nickbild/555_doom_pcb/555_doom_kicad/555_doom_kicad.kicad_pcb

## KiCad design 555_doom_kicad/555_doom_kicad.kicad_pcb (2026-09-07)

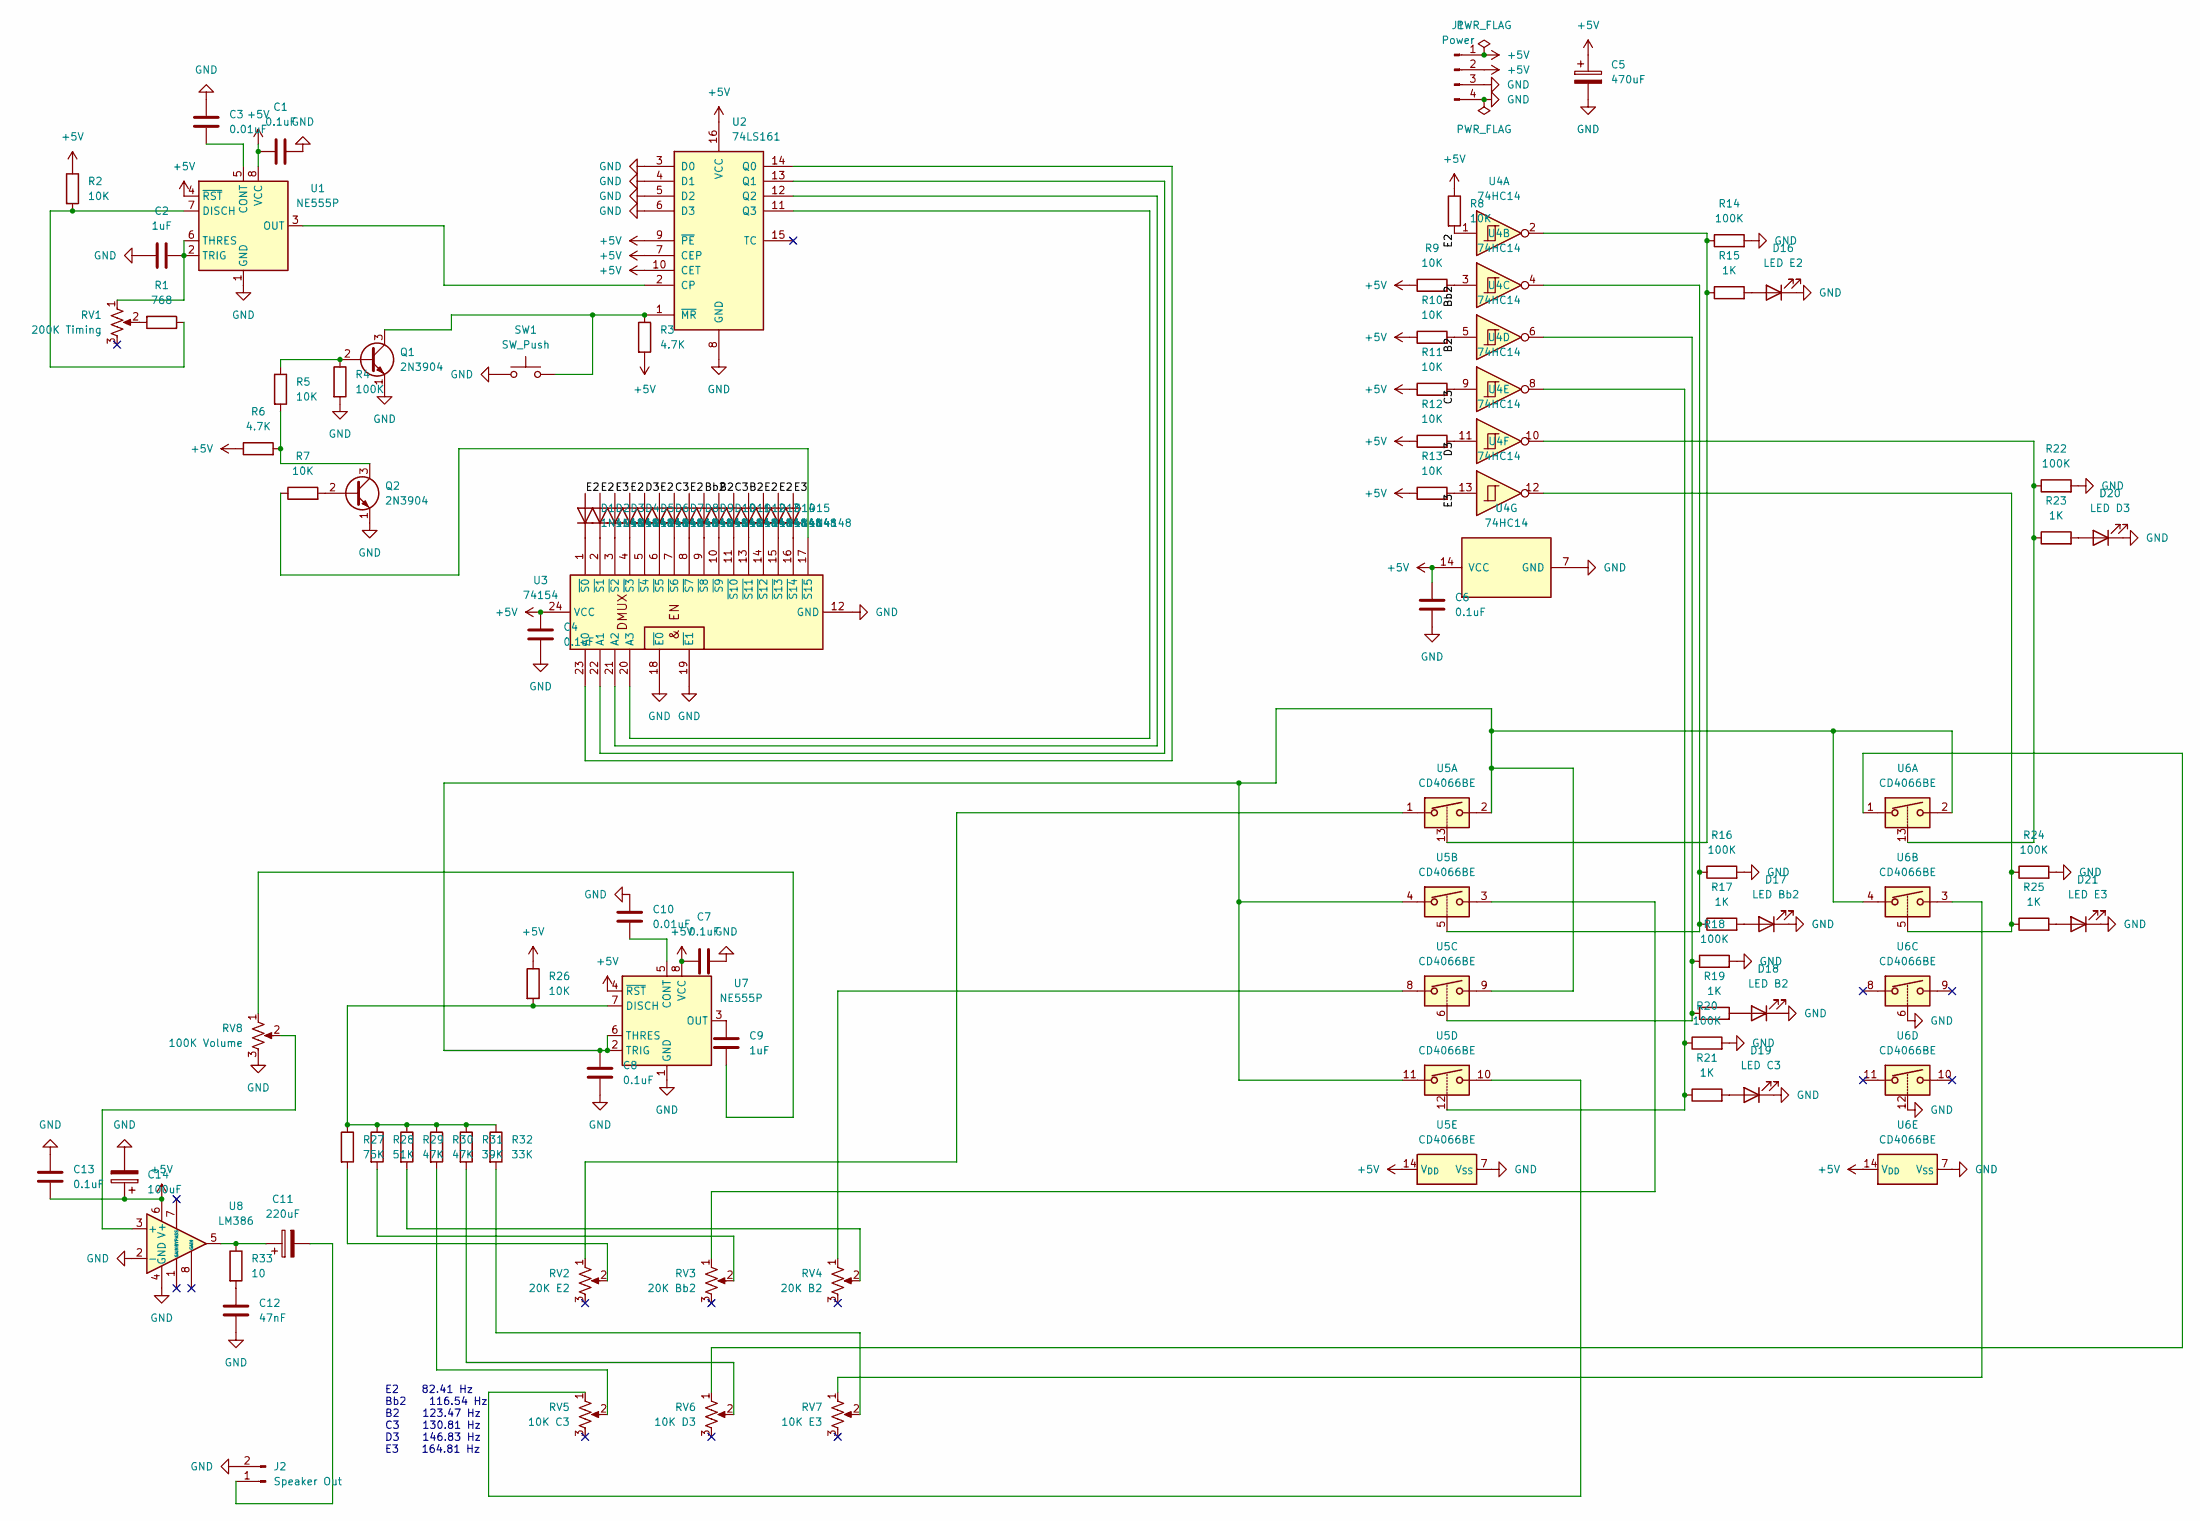
[picture p1: schematic 555_doom_kicad.kicad_sch]

Parts:
C1, C4, C6, C7, C8, C13: 0.1uF; C_Disc_D4.7mm_W2.5mm_P5.00mm
C2, C9: 1uF; C_Disc_D4.7mm_W2.5mm_P5.00mm
C3, C10: 0.01uF; C_Disc_D4.7mm_W2.5mm_P5.00mm
C5: 470uF; CP_Radial_D8.0mm_P2.50mm
C11: 220uF; CP_Radial_D5.0mm_P2.50mm
C12: 47nF; C_Disc_D4.7mm_W2.5mm_P5.00mm
C14: 100uF; CP_Radial_D5.0mm_P2.50mm
D1, D2, D3, D4, D5, D6, D7, D8, D9, D10, D11, D12, D13, D14, D15: 1N4148; D_T-1_P5.08mm_Horizontal
D16: LED E2; LED_D5.0mm
D17: LED Bb2; LED_D5.0mm
D18: LED B2; LED_D5.0mm
D19: LED C3; LED_D5.0mm
D20: LED D3; LED_D5.0mm
D21: LED E3; LED_D5.0mm
J1: Power; PinHeader_1x04_P2.54mm_Vertical
J2: Speaker Out; PinHeader_1x02_P2.54mm_Vertical
Q1, Q2: 2N3904; TO-92_Inline_Wide
R1: 768; R_Axial_DIN0207_L6.3mm_D2.5mm_P7.62mm_Horizontal
R2, R5, R7, R8, R9, R10, R11, R12, R13, R26: 10K; R_Axial_DIN0207_L6.3mm_D2.5mm_P7.62mm_Horizontal
R3, R6: 4.7K; R_Axial_DIN0207_L6.3mm_D2.5mm_P7.62mm_Horizontal
R4, R14, R16, R18, R20, R22, R24: 100K; R_Axial_DIN0207_L6.3mm_D2.5mm_P7.62mm_Horizontal
R15, R17, R19, R21, R23, R25: 1K; R_Axial_DIN0207_L6.3mm_D2.5mm_P7.62mm_Horizontal
R27: 75K; R_Axial_DIN0207_L6.3mm_D2.5mm_P7.62mm_Horizontal
R28: 51K; R_Axial_DIN0207_L6.3mm_D2.5mm_P7.62mm_Horizontal
R29, R30: 47K; R_Axial_DIN0207_L6.3mm_D2.5mm_P7.62mm_Horizontal
R31: 39K; R_Axial_DIN0207_L6.3mm_D2.5mm_P7.62mm_Horizontal
R32: 33K; R_Axial_DIN0207_L6.3mm_D2.5mm_P7.62mm_Horizontal
R33: 10; R_Axial_DIN0207_L6.3mm_D2.5mm_P7.62mm_Horizontal
RV1: 200K Timing; Potentiometer_ACP_CA9-H5_Horizontal
RV2: 20K E2; Potentiometer_ACP_CA9-H5_Horizontal
RV3: 20K Bb2; Potentiometer_ACP_CA9-H5_Horizontal
RV4: 20K B2; Potentiometer_ACP_CA9-H5_Horizontal
RV5: 10K C3; Potentiometer_ACP_CA9-H5_Horizontal
RV6: 10K D3; Potentiometer_ACP_CA9-H5_Horizontal
RV7: 10K E3; Potentiometer_ACP_CA9-H5_Horizontal
RV8: 100K Volume; Potentiometer_ACP_CA9-H5_Horizontal
SW1: SW_Push; SW_PUSH_6mm_H7.3mm
U1, U7: NE555P; DIP-8_W7.62mm
U2: 74LS161; DIP-16_W7.62mm
U3: 74154; DIP-24_W15.24mm
U4: 74HC14; DIP-14_W7.62mm
U5, U6: CD4066BE; DIP-14_W7.62mm
U8: LM386; DIP-8_W7.62mm

Connections:
+5V: C1.1, C4.1, C5.1, C6.1, C7.1, C13.2, C14.1, J1.1, J1.2, R2.1, R3.2, R6.1, R8.1, R9.1, R10.1, R11.1, R12.1, R13.1, R26.1, U1.4 (~RST), U1.8 (VCC), U2.7 (CEP), U2.9 (~PE), U2.10 (CET), U2.16 (VCC), U3.24 (VCC), U4.14 (VCC), U5.14 (V_{DD}), U6.14 (V_{DD}), U7.4 (~RST), U7.8 (VCC), U8.6 (V+)
/B2: D10.2 (A), D12.2 (A), R10.2, U4.5
/Bb2: D9.2 (A), R9.2, U4.3
/C3: D7.2 (A), D11.2 (A), R11.2, U4.9
/D3: D5.2 (A), R12.2, U4.11
/E2: D1.2 (A), D2.2 (A), D4.2 (A), D6.2 (A), D8.2 (A), D13.2 (A), D14.2 (A), R8.2, U4.1
/E3: D3.2 (A), D15.2 (A), R13.2, U4.13
GND: C1.2, C2.2, C3.1, C4.2, C5.2, C6.2, C7.2, C8.2, C10.1, C12.2, C13.1, C14.2, D16.1 (K), D17.1 (K), D18.1 (K), D19.1 (K), D20.1 (K), D21.1 (K), J1.3, J1.4, J2.2, Q1.1 (E), Q2.1 (E), R4.2, R14.2, R16.2, R18.2, R20.2, R22.2, R24.2, RV8.3, SW1.1, U1.1 (GND), U2.3 (D0), U2.4 (D1), U2.5 (D2), U2.6 (D3), U2.8 (GND), U3.12 (GND), U3.18 (~E0), U3.19 (~E1), U4.7 (GND), U5.7 (V_{SS}), U6.6, U6.7 (V_{SS}), U6.12, U7.1 (GND), U8.2 (-), U8.4 (GND)
unnamed: C9.2, RV8.1
unnamed: C11.1, R33.1, U8.5
unnamed: C12.1, R33.2
unnamed: D1.1 (K), U3.1 (~S0)
unnamed: D2.1 (K), U3.2 (~S1)
unnamed: D3.1 (K), U3.3 (~S2)
unnamed: D4.1 (K), U3.4 (~S3)
unnamed: D5.1 (K), U3.5 (~S4)
unnamed: D6.1 (K), U3.6 (~S5)
unnamed: D7.1 (K), U3.7 (~S6)
unnamed: D8.1 (K), U3.8 (~S7)
unnamed: D9.1 (K), U3.9 (~S8)
unnamed: D10.1 (K), U3.10 (~S9)
unnamed: D11.1 (K), U3.11 (~S10)
unnamed: D12.1 (K), U3.13 (~S11)
unnamed: D13.1 (K), U3.14 (~S12)
unnamed: D14.1 (K), U3.15 (~S13)
unnamed: D15.1 (K), U3.16 (~S14)
unnamed: D16.2 (A), R15.2
unnamed: D17.2 (A), R17.2
unnamed: D18.2 (A), R19.2
unnamed: D19.2 (A), R21.2
unnamed: D20.2 (A), R23.2
unnamed: D21.2 (A), R25.2
unnamed: C11.2, J2.1
unnamed: Q1.2 (B), R4.1, R5.1
unnamed: Q1.3 (C), R3.1, SW1.2, U2.1 (~MR)
unnamed: Q2.2 (B), R7.2
unnamed: Q2.3 (C), R5.2, R6.2
unnamed: R1.2, RV1.2
unnamed: R14.1, R15.1, U4.2, U5.13
unnamed: R16.1, R17.1, U4.4, U5.5
unnamed: R18.1, R19.1, U4.6, U5.6
unnamed: R20.1, R21.1, U4.8, U5.12
unnamed: R22.1, R23.1, U4.10, U6.13
unnamed: R24.1, R25.1, U4.12, U6.5
unnamed: R27.2, RV2.2
unnamed: R28.2, RV3.2
unnamed: R29.2, RV4.2
unnamed: R30.2, RV5.2
unnamed: R31.2, RV6.2
unnamed: R32.2, RV7.2
unnamed: RV2.1, U5.1
unnamed: RV3.1, U5.3
unnamed: RV4.1, U5.8
unnamed: RV5.1, U5.10
unnamed: RV6.1, U6.1
unnamed: RV7.1, U6.3
unnamed: C3.2, U1.5 (CONT)
unnamed: R1.1, R2.2, U1.7 (DISCH)
unnamed: U1.3 (OUT), U2.2 (CP)
unnamed: C2.1, RV1.1, U1.2 (TRIG), U1.6 (THRES)
unnamed: U2.14 (Q0), U3.23 (A0)
unnamed: U2.13 (Q1), U3.22 (A1)
unnamed: U2.12 (Q2), U3.21 (A2)
unnamed: U2.11 (Q3), U3.20 (A3)
unnamed: R7.1, U3.17 (~S15)
unnamed: C10.2, U7.5 (CONT)
unnamed: R26.2, R27.1, R28.1, R29.1, R30.1, R31.1, R32.1, U7.7 (DISCH)
unnamed: C9.1, U7.3 (OUT)
unnamed: C8.1, U5.2, U5.4, U5.9, U5.11, U6.2, U6.4, U7.2 (TRIG), U7.6 (THRES)
unnamed: RV8.2, U8.3 (+)

Notes on the sheet:
E2 82.41 Hz Bb2 116.54 Hz B2 123.47 Hz C3 130.81 Hz D3 146.83 Hz E3 164.81 Hz

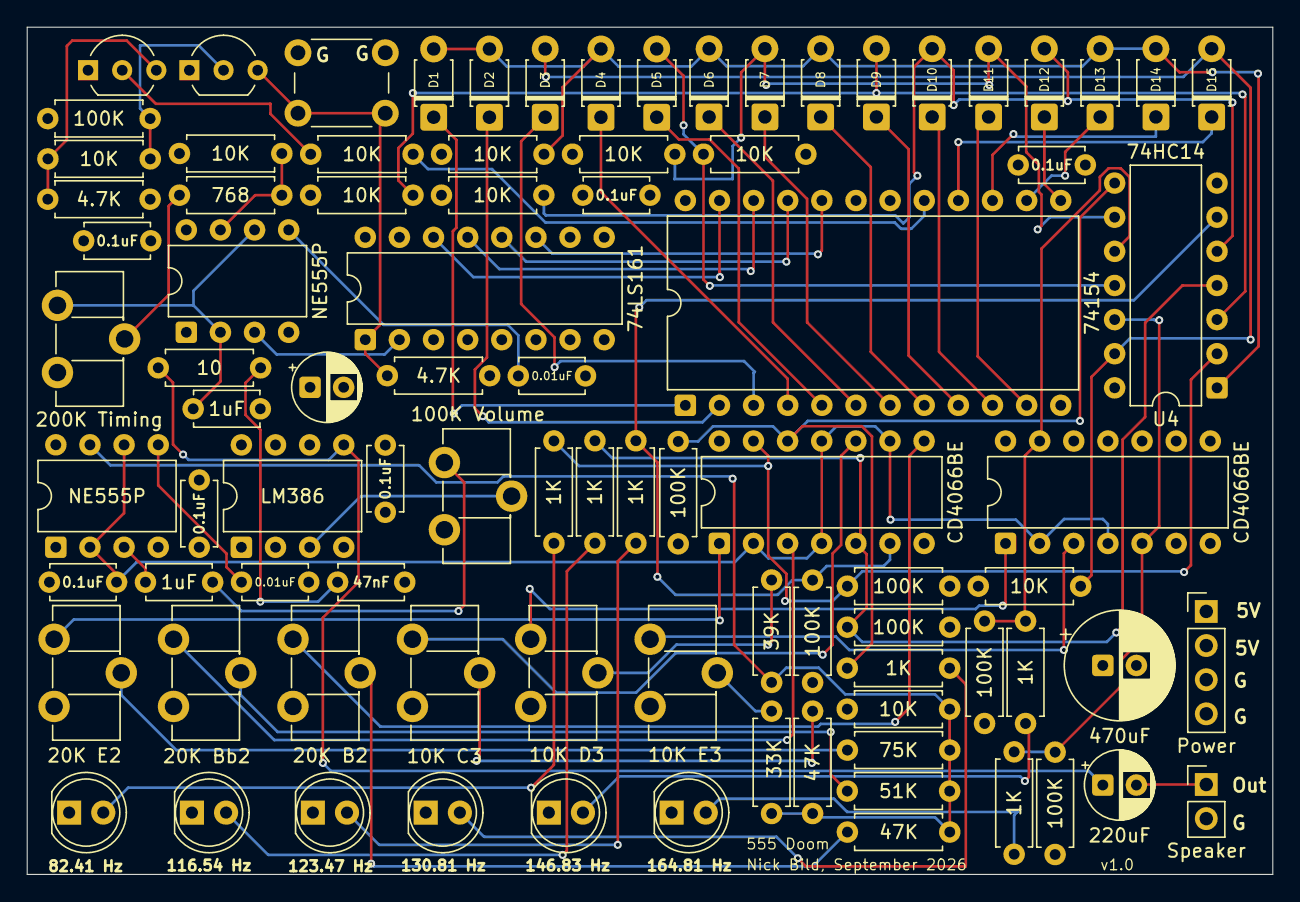
[picture p2: board 555_doom_kicad.kicad_pcb from above]

Board: 4 copper layers, 92.7 x 63.0 mm, 89 parts (0 on the bottom side), 70 nets.
